bestlaptop-com-ua/prize-wheel/(commit log)

2026-07-22 Prize wheel firmware: P1 sensing revision + project documentation
2026-07-24 Two-leg direction probe + takeover fight watchdog
    The p probe now runs FAS+ then FAS- and requires opposite encoder signs, so a stuck/dead DIR line (the prime suspect for CW-only step skipping and rattle) is caught during attended calibration instead of during a guest spin. A same-sign result clears the persisted calibration and locks all automatic moves. The takeover loop gains a fight watchdog: 120 ms after step pulses begin, if the wheel's forward speed is below 45% of the live FAS-commanded speed, the motor is fighting the wheel (DIR fault, phase fight, or belt tooth-jump) and the move is released to freewheel immediately, instead of waiting for a wheel reversal that a 100-300 mA fight c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
    [prize_wheel.ino]
2026-07-24 Recovery reads as one decisive notch; gentle spins get the disguised takeover
    Dare recovery now runs at 900 usteps/s (~50 deg/s at the wheel) instead of the 7 deg/s crawl, with the stop lead computed from FAS's live stopping distance so the higher speed cannot overshoot the safe target into the next wedge. TAKEOVER_MIN_PEAK_REV_S drops 0.28 -> 0.16 so gentle spins are steered by the friction-disguised takeover instead of being left to die on a dare and trigger the visible recovery.
    [prize_wheel.ino]
2026-07-30 Port frame fix to mid-spin firmware (from 5062075): static label-true frame on rawZero uint16 anchor (default 3807); wedge identity from (rawZero-raw) mod 4096, reboot-proof; prime/nearest-turn snap 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
    [prize_wheel.ino]
2026-07-30 Record correction for e1cfaf3: file content is the resident session's independent port (frame fix + friction-fit + Mode-relocation), which overwrote the assistant's port in the working tree pre-commi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
2026-07-30 Variant v2 naturalness: engage window 0.28->0.45 rev/s; pick wedge first then engage when it sits at 0.75-1.35x natural stop distance (friction-model geometry); command decel follows fitted C+B*w cur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
2026-07-31 Variant v3 safety+authority: live per-spin friction estimate replaces bad seeds (fixes wrong natural distance -> impossible profiles); brake current 280->450mA (kills phase-slip); force-engage sanity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
    [prize_wheel_nopredict.ino]
2026-07-31 Variant v4 currents+earliness from proven v4.x ladder: capture 600mA -> cruise 450mA after 500ms lock (180mA capture was the rattle; 650 documented as humming); engage ceiling 0.45->0.60 rev/s; absol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
    [prize_wheel_nopredict.ino]
2026-07-31 prize_wheel_gpt: the full ChatGPT build (6ff8d5d - disguised takeover + decisive-notch recovery, all original tuning) with ONLY the label-true rawZero frame fix ported (static seed/snap, z persists r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
    [prize_wheel_gpt.ino]
2026-07-31 prize_wheel_gpt policy per owner: universal engagement (prediction gate removed, kept for logs), intercept window raised 0.26->0.55 rev/s, dare recovery disabled - every confirmed spin is steered to 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
2026-07-31 prize_wheel_gpt: hand-release gate (500ms spin age + speed<92% of peak) so takeover never fires during the push; targets exclude dare-adjacent wedges (landing scatter ~1 wedge); dare landings now pri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
    [prize_wheel_gpt.ino]
2026-07-31 prize_wheel_gpt: brake-physics-honest targeting - per-decision runway ceiling = distance to predicted natural stop minus 5deg (a brake can only shave, never add), +15deg headroom above min-brake dist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
    [prize_wheel_gpt.ino]
2026-07-31 Handoff for ChatGPT/Codex: the label-true rawZero frame - math, physical mapping, multiturn invariant, z protocol, the historical mirror bug and its symptoms, verification protocol, current build sta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
2026-07-31 prize_wheel_gpt: friction-honest brake floor (motor+friction decel), margin 35->20, live-dir guard on runway ceiling, terminal LANDED-DARE in RECOVERY_HOLD when recovery disabled. Fixes engagement st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
    [prize_wheel_gpt.ino]
2026-07-31 prize_wheel_gpt: Priority-2 friction calibration from bench coast data - c=0.031 b=0.21 (was seeded 0.30/0.15). Real wheel coasts 3x longer than seeded model; brake-only ceiling was starving targetin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
